Kikiman2/HumbleBot/README.md

# HumbleBot
My thesis repository is at the Faculty of Mechanical Engineering of Óbuda University.
