Kikiman2/HumbleBot/humblebot_description/urdf/image.png

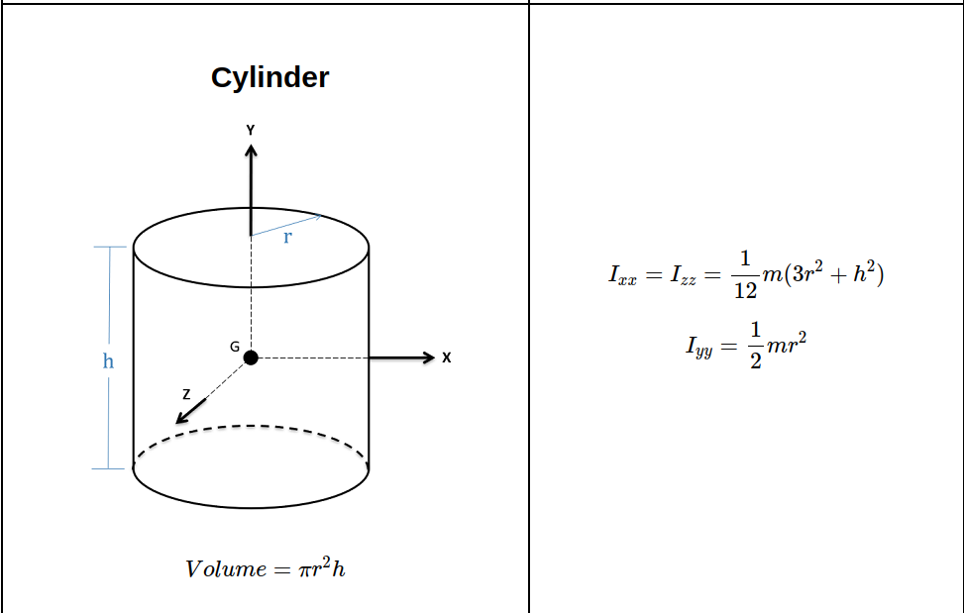
humblebot_description/urdf/image.png
