Kikiman2/HumbleBot/humblebot_documentation/Models/Wall_Raspberry.stl

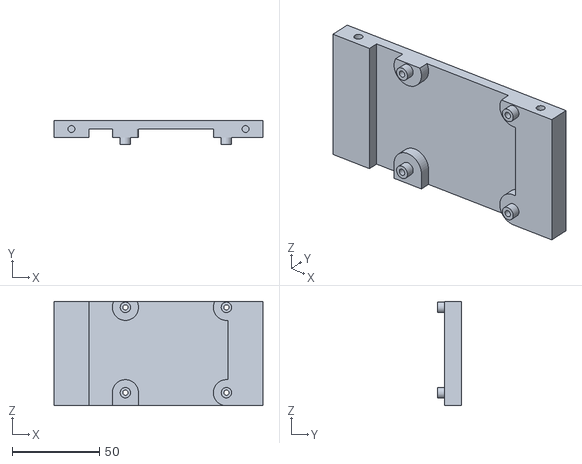
[picture p20: CAD file, 2025-04-08]
humblebot_documentation/Models/Wall_Raspberry.stl
120.0 x 14.0 x 60.0
