Kikiman2/HumbleBot/humblebot_documentation/Models/Wall_Pi_camera.stl

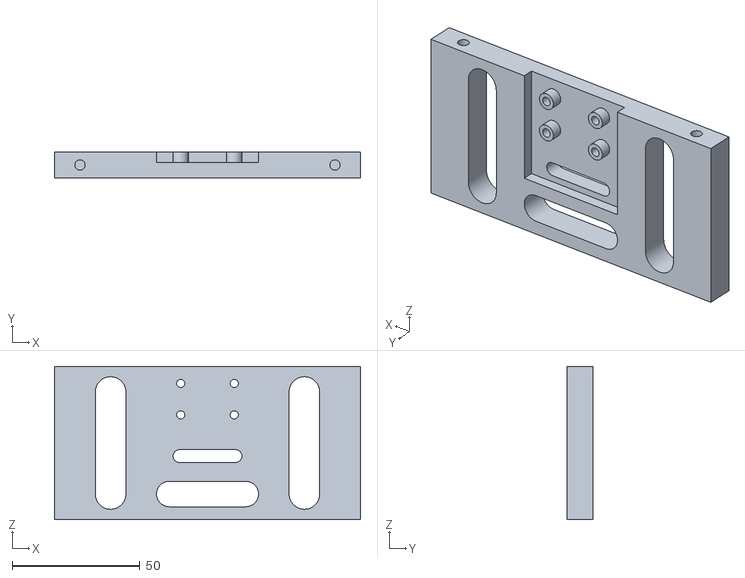
[picture p21: CAD file, 2025-04-08]
humblebot_documentation/Models/Wall_Pi_camera.stl
120.0 x 10.0 x 60.0
