Kikiman2/HumbleBot/humblebot_documentation/Models/Omni_spacer.stl

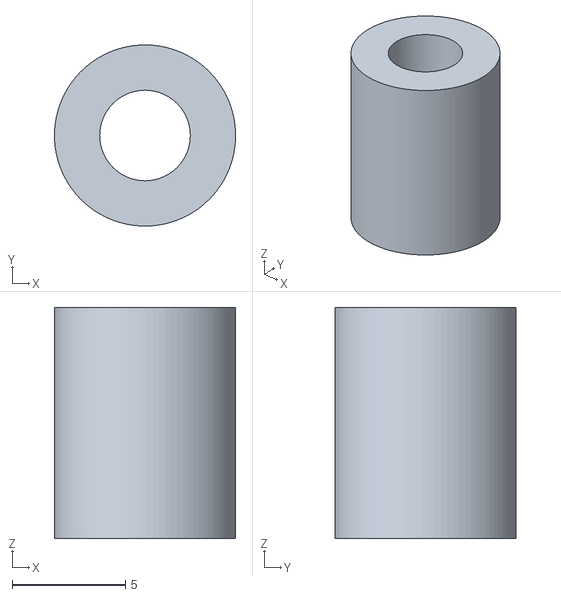
[picture p22: CAD file, 2025-04-08]
humblebot_documentation/Models/Omni_spacer.stl
8.00 x 8.00 x 10.2
