Kikiman2/HumbleBot/humblebot_documentation/Models/Wall_motor_shield.stl

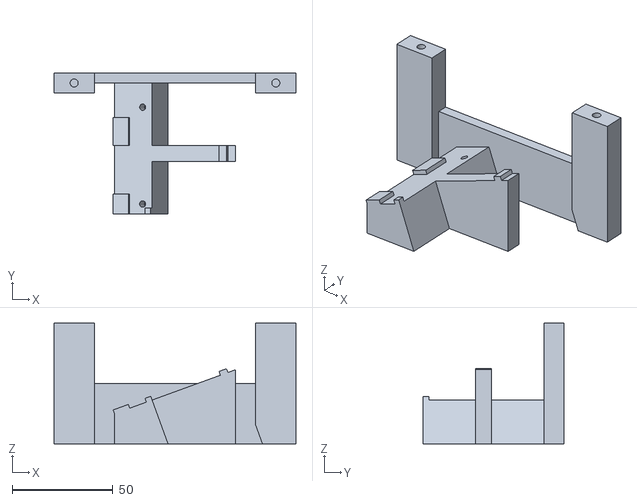
[picture p23: CAD file, 2025-04-08]
humblebot_documentation/Models/Wall_motor_shield.stl
120.0 x 70.0 x 60.0
