Kikiman2/HumbleBot/humblebot_documentation/Models/Omni_roller.stl

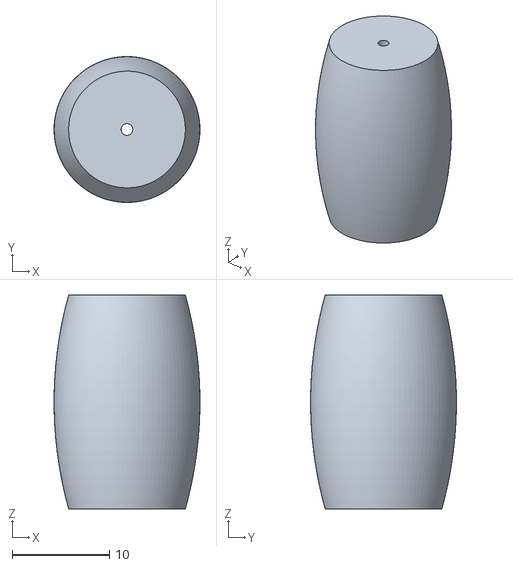
[picture p24: CAD file, 2025-04-08]
humblebot_documentation/Models/Omni_roller.stl
15.0 x 15.0 x 22.0
