Kikiman2/HumbleBot/humblebot_documentation/Models/Top_floor.stl

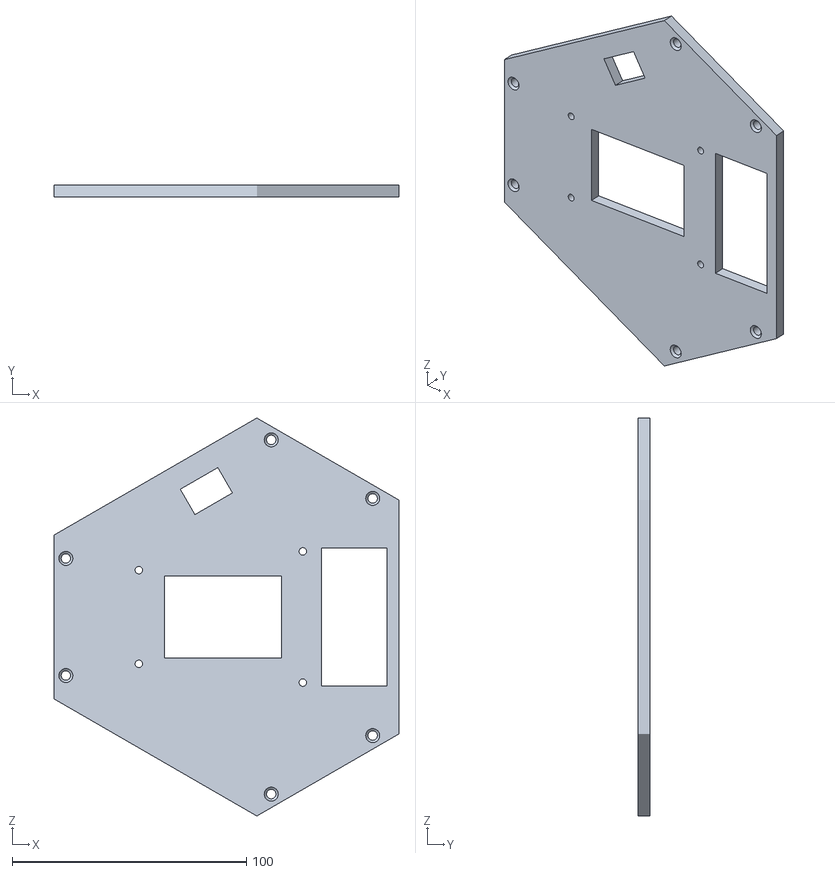
[picture p25: CAD file, 2025-04-08]
humblebot_documentation/Models/Top_floor.stl
147.1 x 5.00 x 169.9
