Kikiman2/HumbleBot/humblebot_documentation/Models/bearing_holder.stl

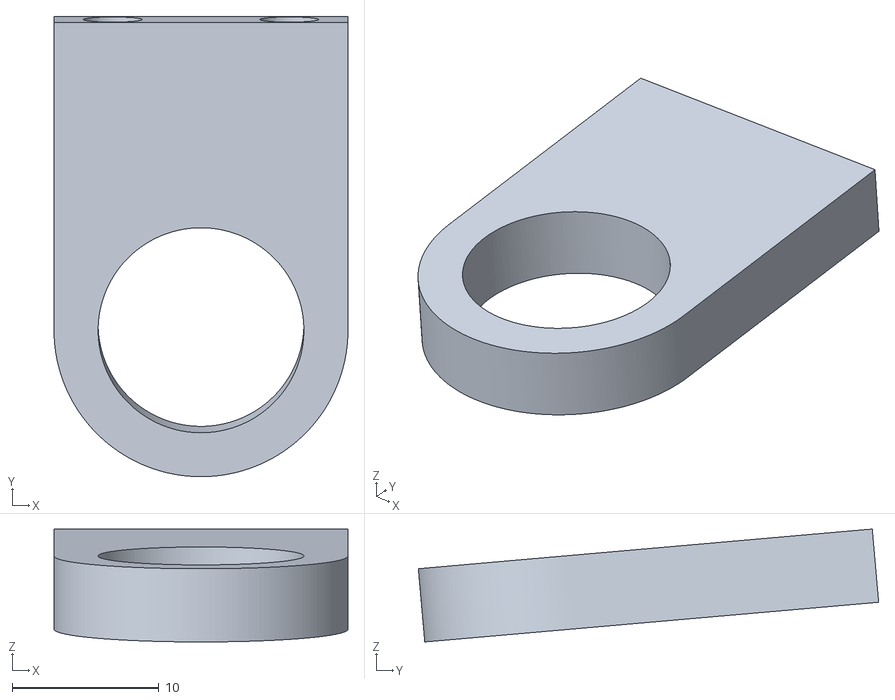
[picture p26: CAD file, 2025-04-08]
humblebot_documentation/Models/bearing_holder.stl
20.0 x 31.3 x 7.68
