Kikiman2/HumbleBot/humblebot_documentation/Models/2nd_floor.stl

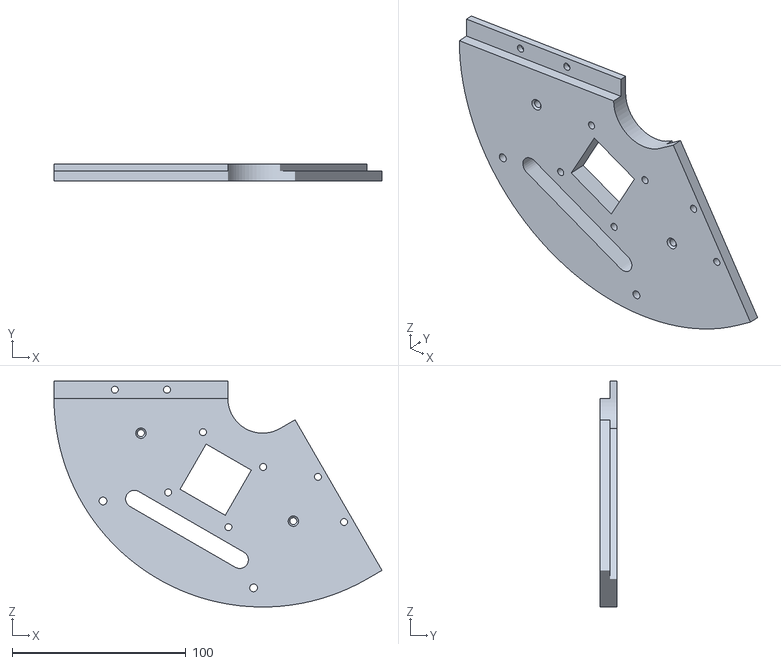
[picture p27: CAD file, 2025-04-08]
humblebot_documentation/Models/2nd_floor.stl
188.7 x 10.0 x 130.0
