Kikiman2/HumbleBot/humblebot_documentation/Models/Omni_2.stl

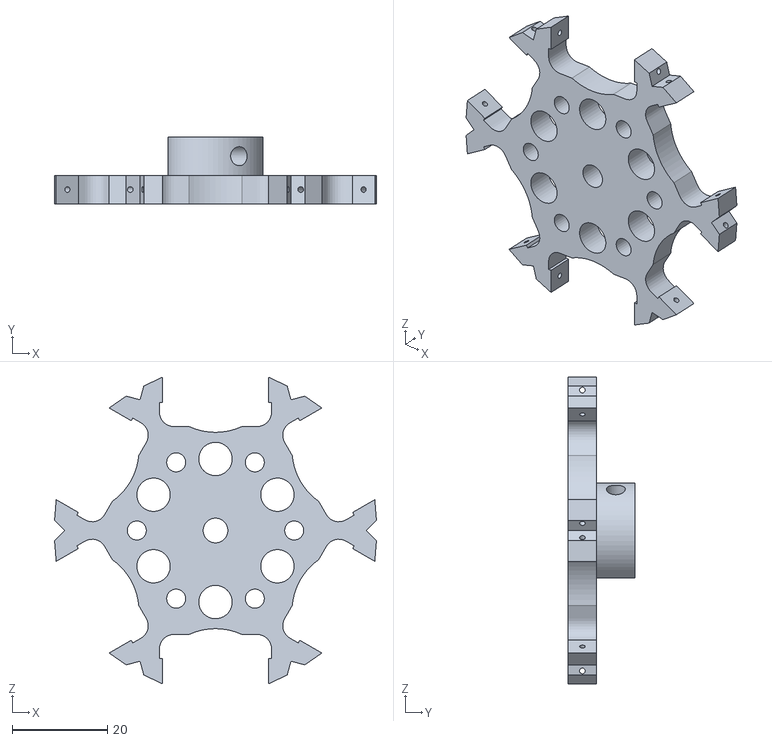
[picture p28: CAD file, 2025-04-08]
humblebot_documentation/Models/Omni_2.stl
67.5 x 14.0 x 64.3
