Kikiman2/HumbleBot/humblebot_documentation/Models/Base.stl

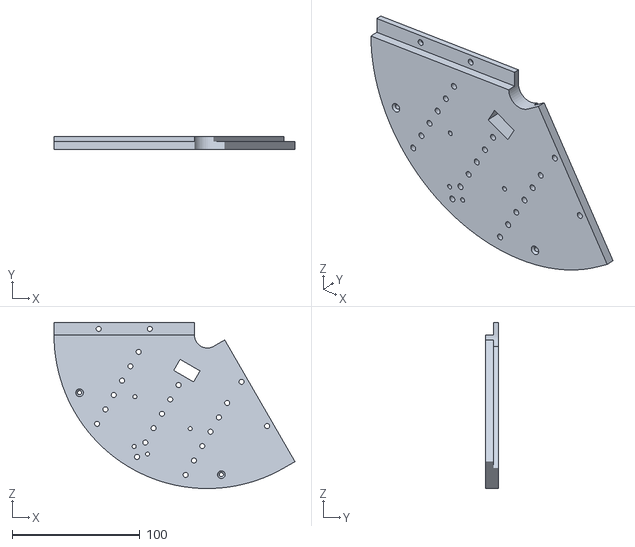
[picture p29: CAD file, 2025-04-08]
humblebot_documentation/Models/Base.stl
188.7 x 10.0 x 130.0
