Kikiman2/HumbleBot/humblebot_documentation/Models/Omni_1.stl

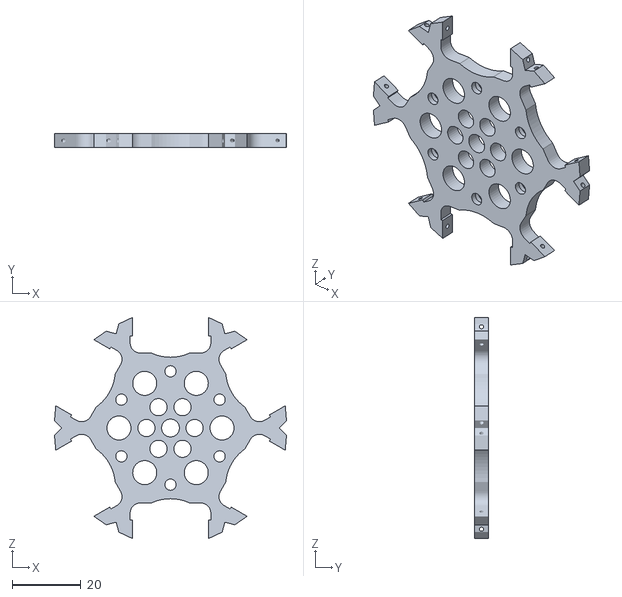
[picture p30: CAD file, 2025-04-08]
humblebot_documentation/Models/Omni_1.stl
67.5 x 4.00 x 64.3
