Kikiman2/HumbleBot/humblebot_documentation/Models/Wall_RPLidar.stl

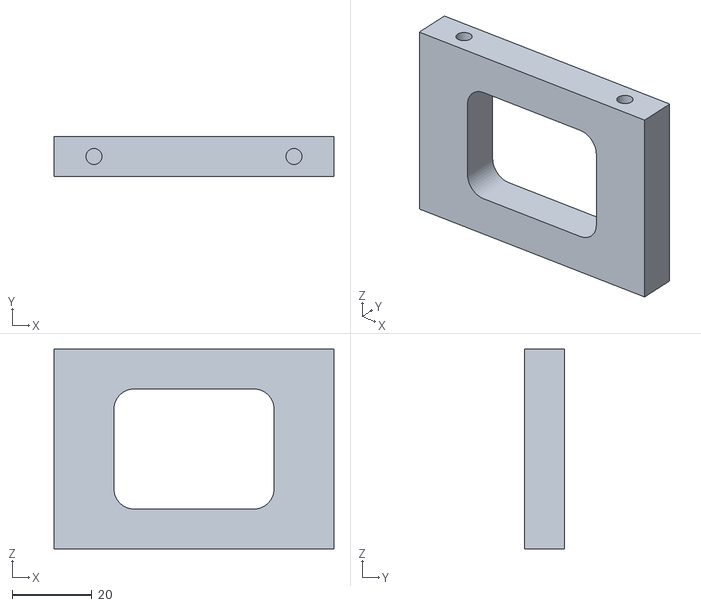
[picture p31: CAD file, 2025-04-08]
humblebot_documentation/Models/Wall_RPLidar.stl
70.0 x 10.0 x 50.0
