Kikiman2/HumbleBot/humblebot_documentation/Models/Motor_holder.stl

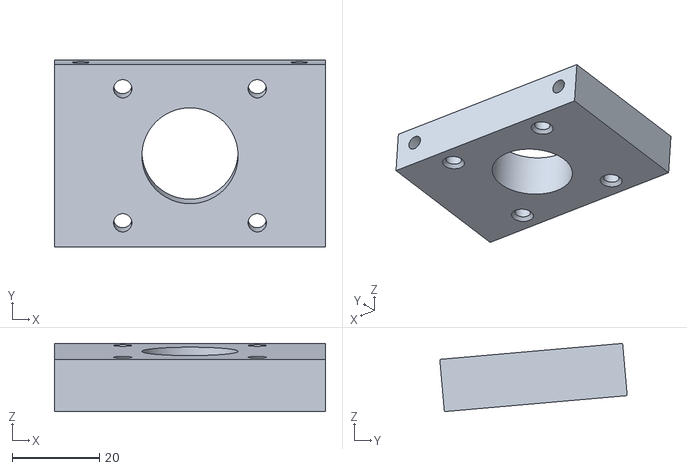
[picture p32: CAD file, 2025-04-08]
humblebot_documentation/Models/Motor_holder.stl
62.0 x 42.9 x 15.6
