Kikiman2/HumbleBot/(list of files, cad)

Other CAD files:
humblebot_documentation/Models/2nd_floor.f3d
humblebot_documentation/Models/Base.f3d
humblebot_documentation/Models/Motor_wheel_holder.f3z
humblebot_documentation/Models/Omni_1.f3d
humblebot_documentation/Models/Omni_2.f3d
humblebot_documentation/Models/Omni_roller.f3d
humblebot_documentation/Models/Omni_spacer.f3d
humblebot_documentation/Models/Top_floor.f3z
humblebot_documentation/Models/Wall_Pi_camera.f3z
humblebot_documentation/Models/Wall_RPLidar.f3d
humblebot_documentation/Models/Wall_Raspberry.f3d
humblebot_documentation/Models/Wall_moto_shield.f3z
