Kikiman2/HumbleBot/humblebot_documentation/Documents/Motor tengely.pdf

Ø

5.15

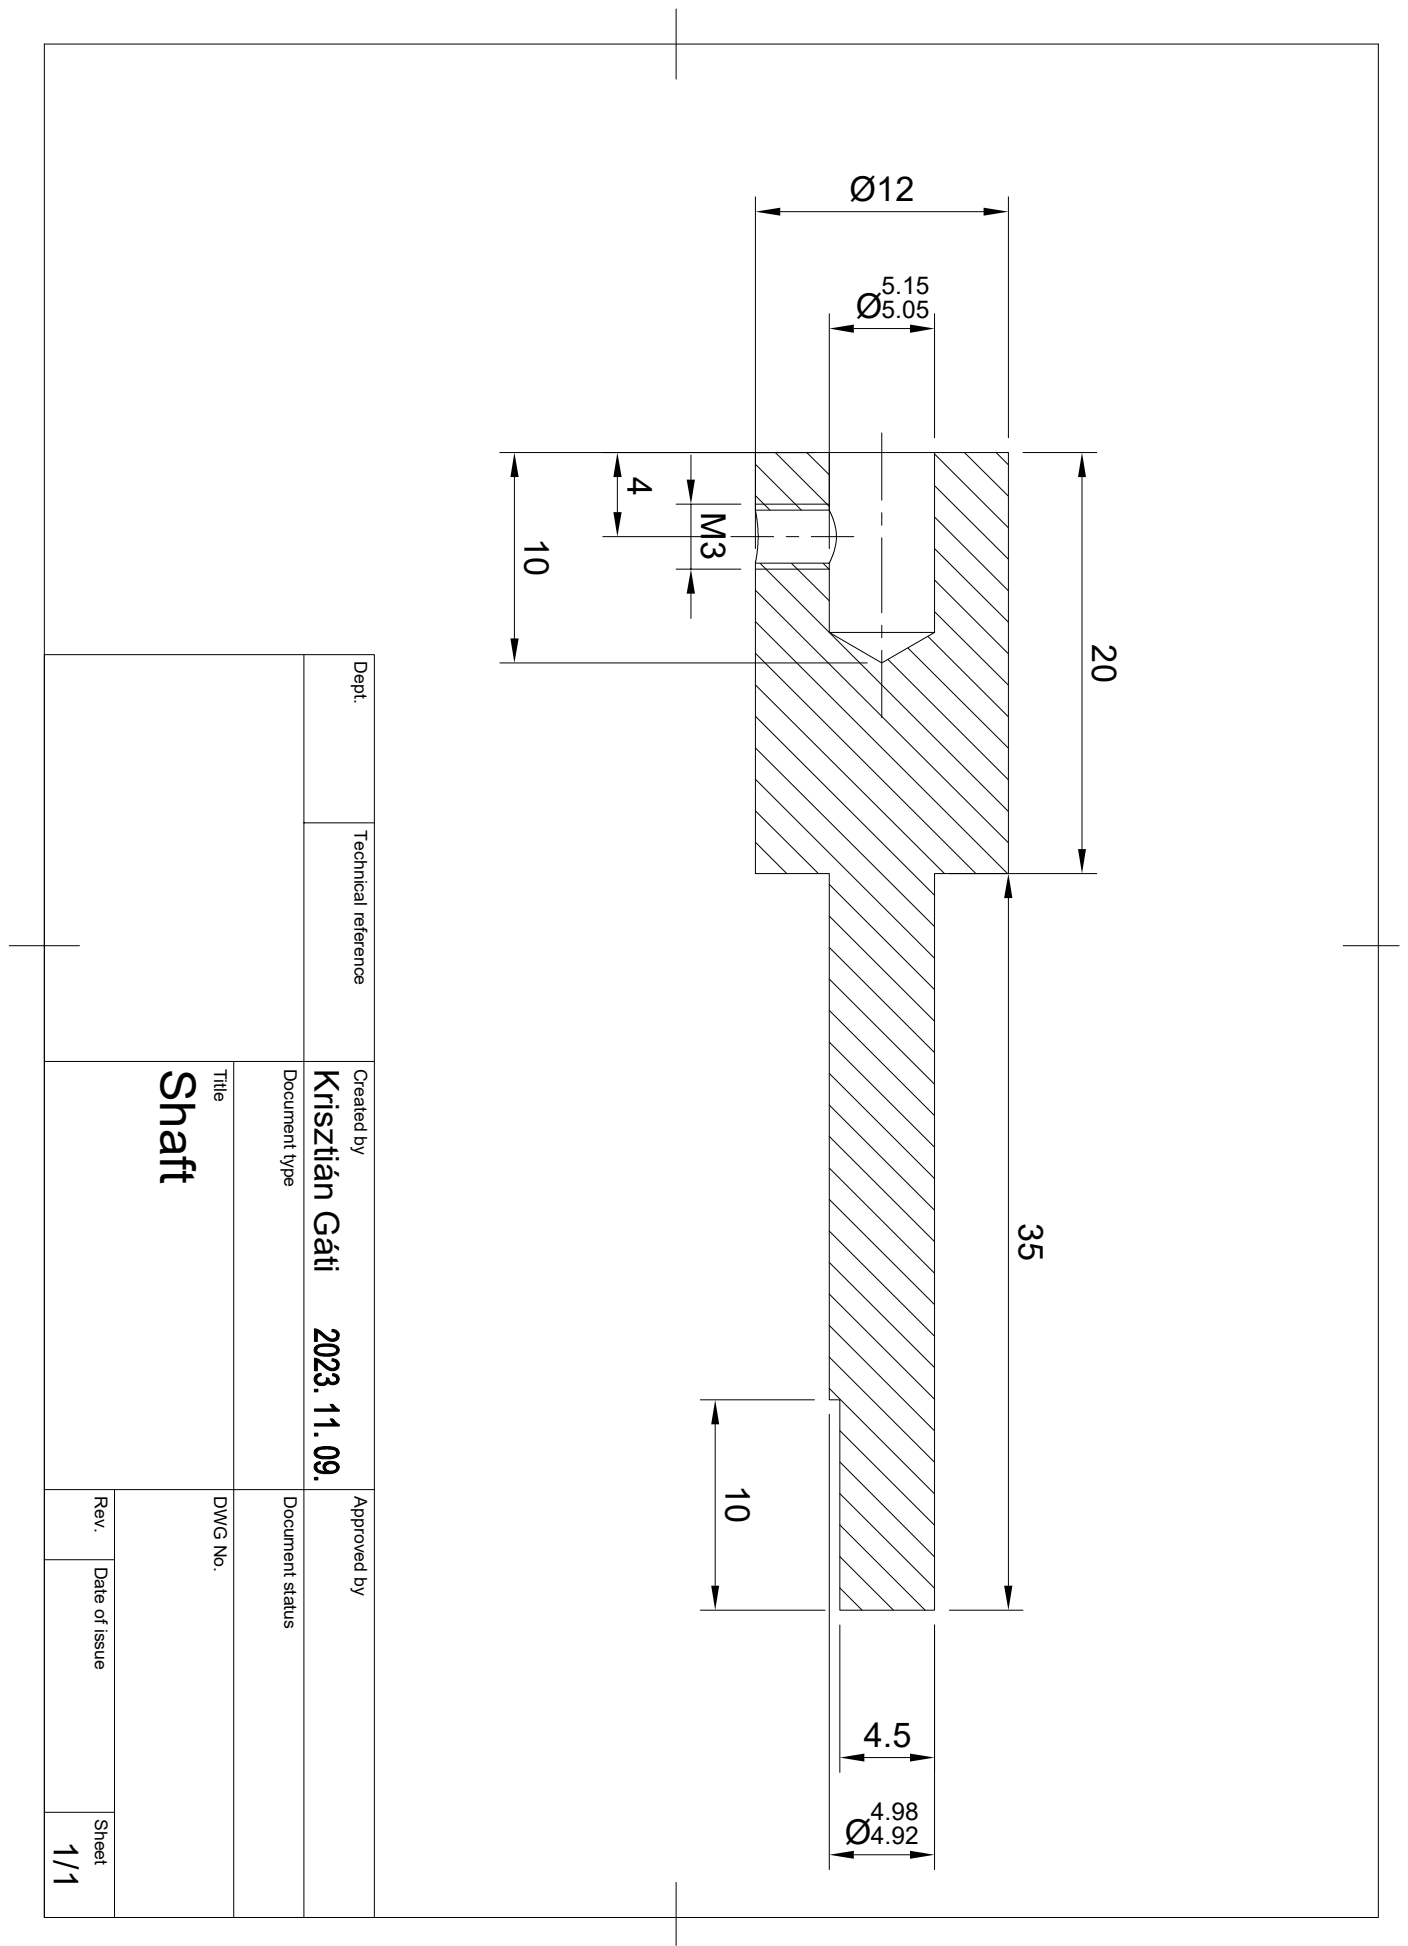
[picture p33: page 1]

Dept. Technical reference Created by Approved by Title DWG No. Document type Document status Rev. Date of issue Sheet 1/1 Shaft Krisztián Gáti 20 35
