Kikiman2/HumbleBot/(commit log)

2023-10-29 Started to write the wheel velocity control node.
2023-11-17 Added the stepper logic to the arduino
2023-11-17 Improved the logic if the wheel velocity measuments
2023-11-20 Modified veloctiy control algoritm
2023-11-22 Changed the stepper control
2025-04-08 Uploaded models, thesis document & presentation
    [2nd_floor.f3d, 2nd_floor.stl, Base.f3d, Base.stl, Mobil robot alkatrészek.xlsx, Motor_holder.stl, Motor_wheel_holder.f3z, Omni_1.f3d]
2025-05-05 Added urdf file with base and two wheels
    [humblebot.urdf]
2025-05-06 Added wheels to the urdf & Added a launch file
    [humblebot.urdf]
2025-12-01 Added xacro
    [humblebot.urdf, humblebot.xacro]
2025-12-02 xacro update & Gazebo launch
    [common_properties.xacro, humblebot.urdf, humblebot.xacro, mobile_base.xacro]
2025-12-03 Update wheel_vel
2025-12-03 Update velocity control node
2025-12-11 Rplidar has been added
    [humblebot.xacro, lidar.xacro]
2025-12-14 wheel velicities final commit
2025-12-14 Final commit before the deadline
    [humblebot.xacro]
2025-12-14 Fenal commit before the deadline
    [common_properties.xacro]
